bartoolina/Portable-Sig-Gen/schematics/dds_cahnnel_v1.pdf

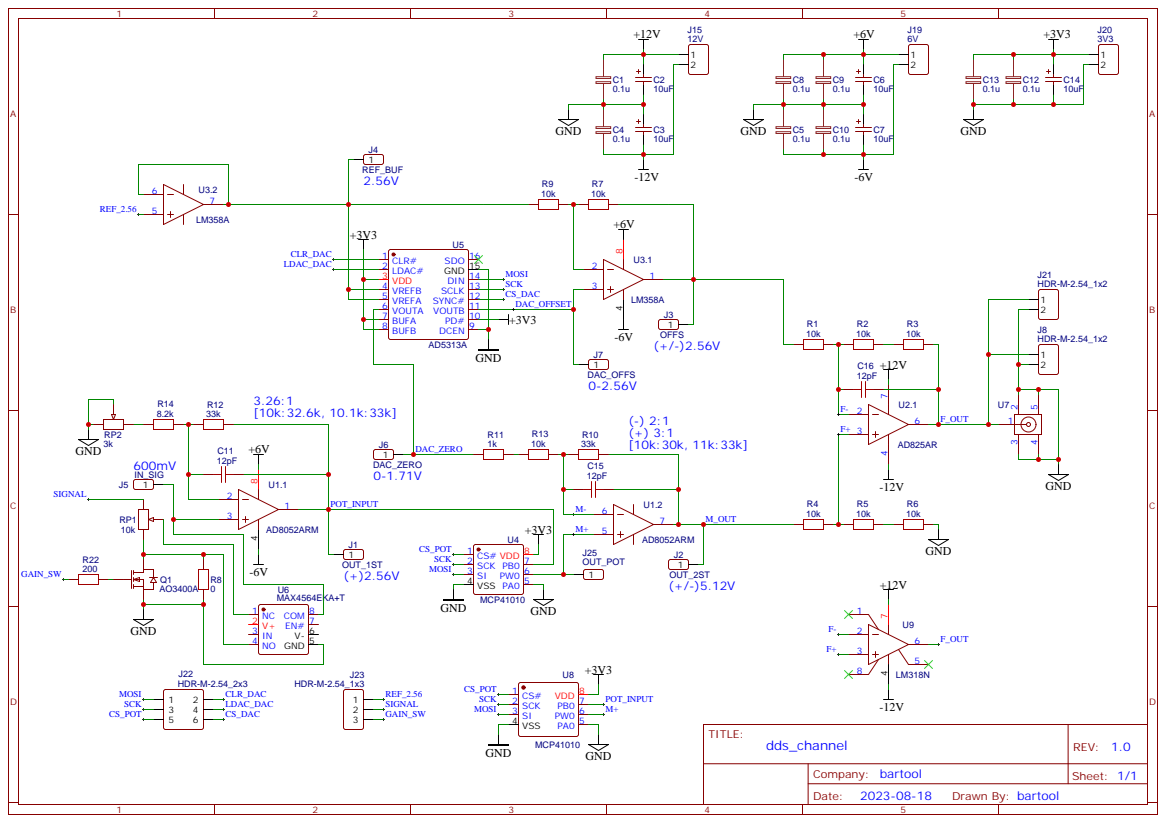
[picture p2: page 1]

PD# 10 VOUTB 11 SYNC# 12 SCLK 13 DIN 14 GND 15 SDO 16
