bartoolina/Portable-Sig-Gen/schematics/frontpanel_v1.pdf

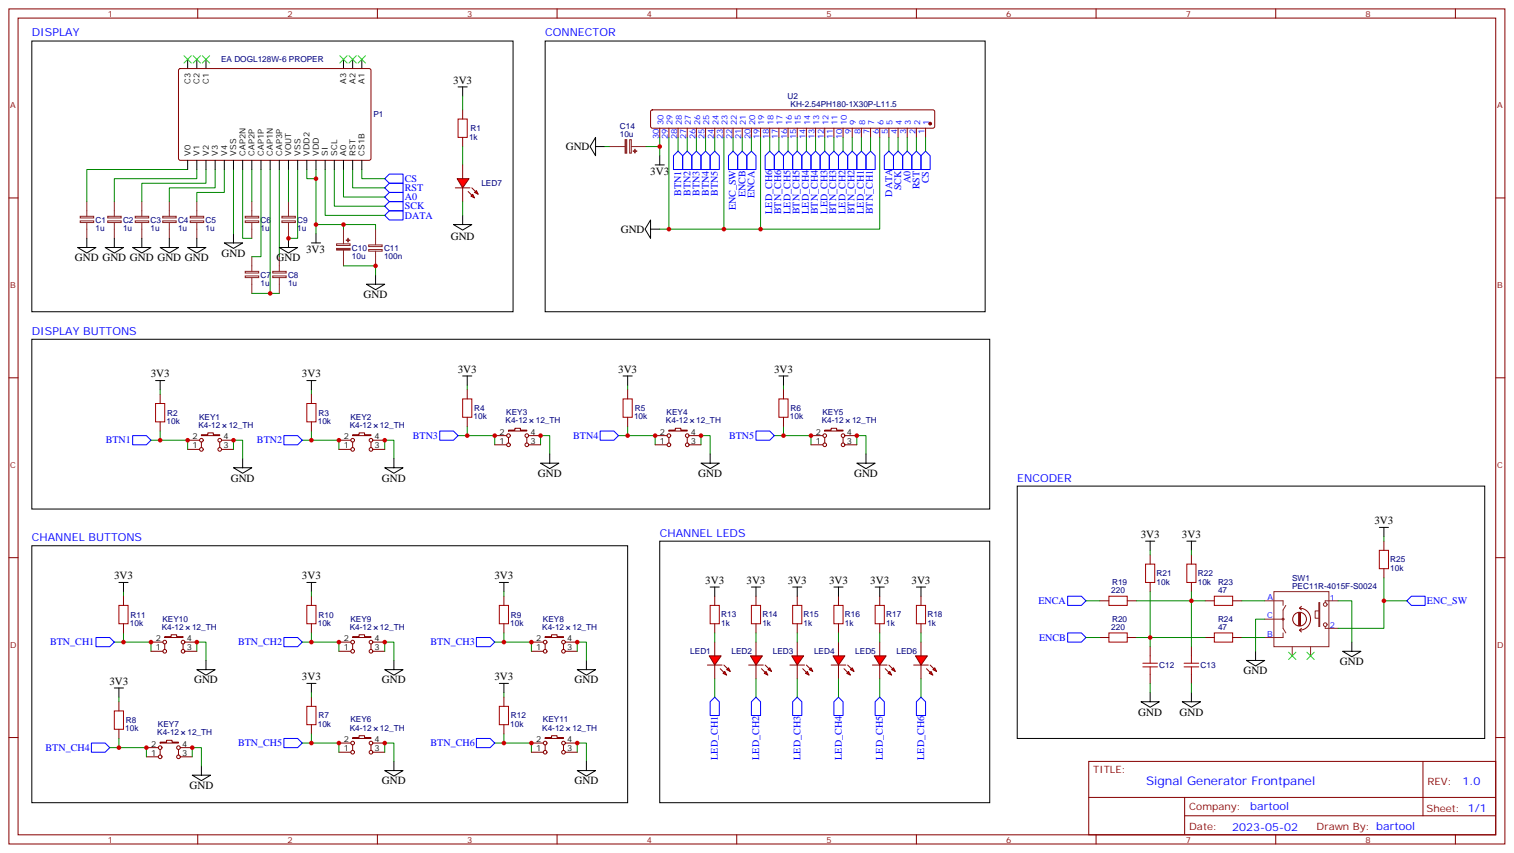
[picture p3: page 1]

GND GND GND
