bartoolina/Portable-Sig-Gen/schematics/dds_channel_v2.pdf

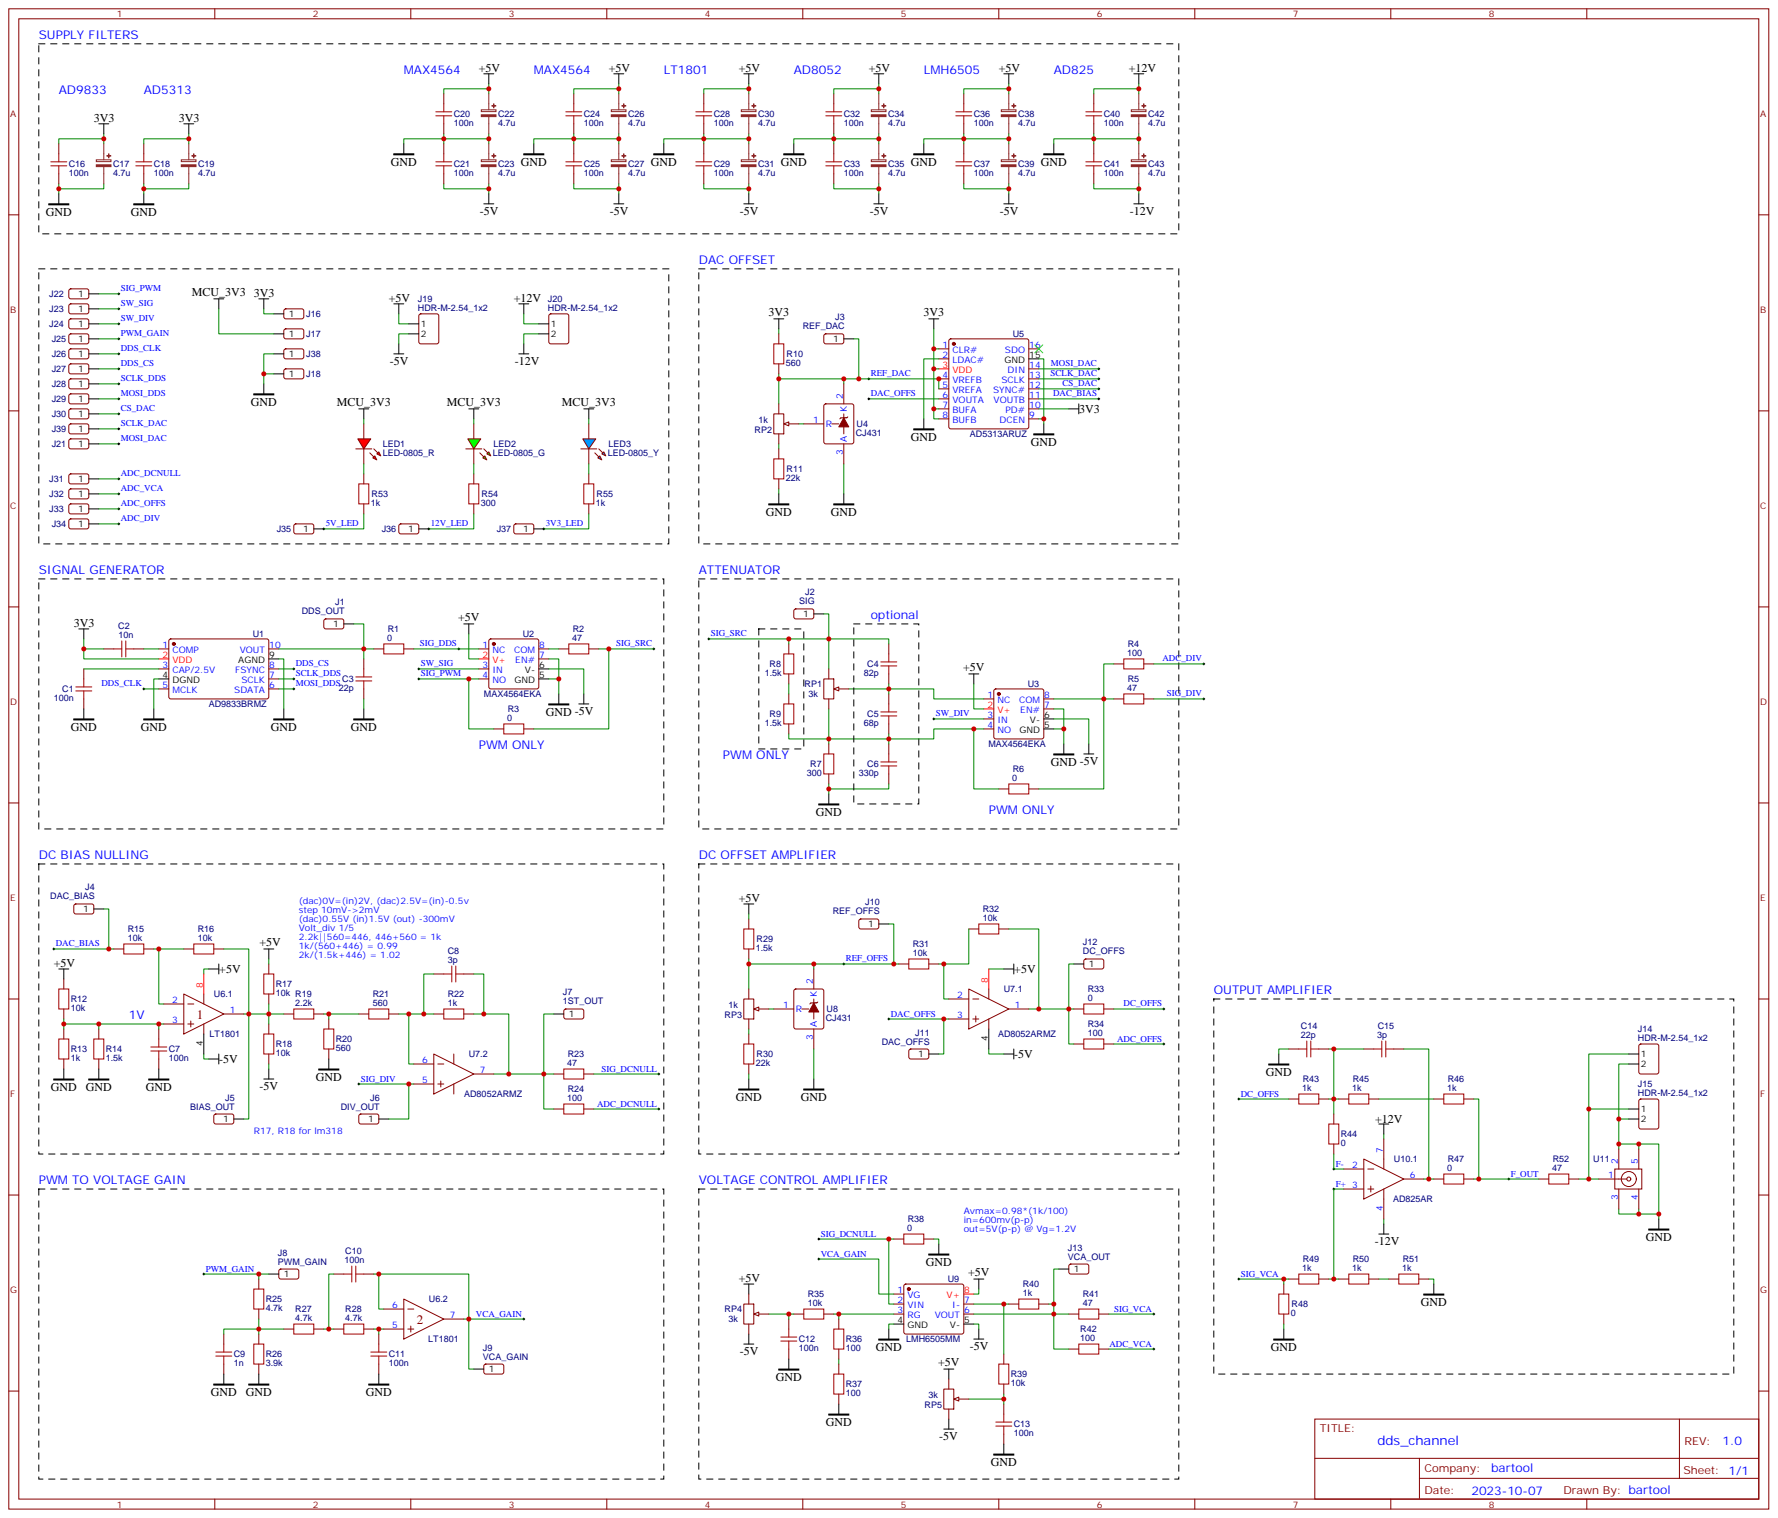
[picture p4: page 1]
