bartoolina/Portable-Sig-Gen/schematics/dds_test_board_v1.pdf

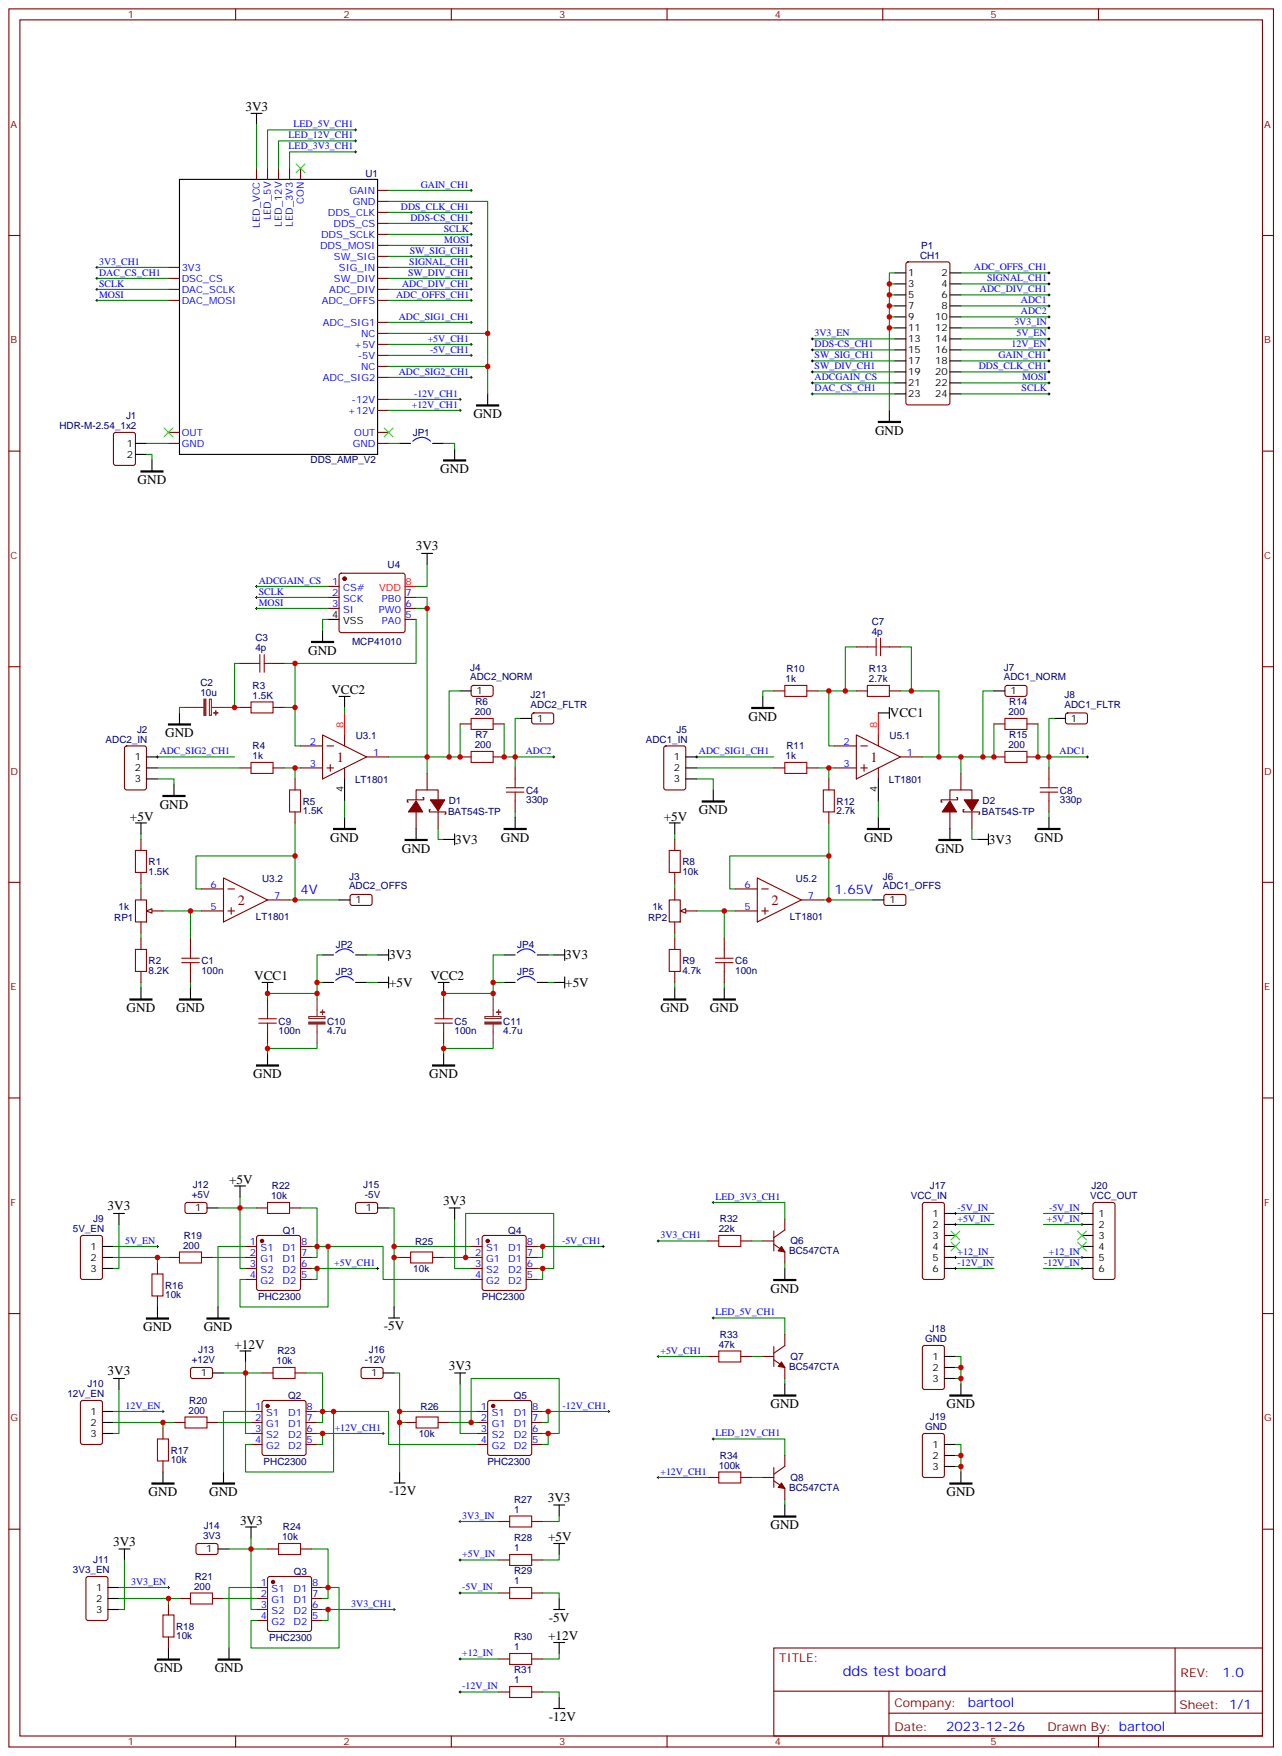
[picture p5: page 1]
