bartoolina/Portable-Sig-Gen/firmware/PortableSigGen_g474re_rtos/Core/Src/main.c

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
/* Includes ------------------------------------------------------------------*/
#include "main.h"
// #include "cmsis_os.h"
#include "usart.h"
#include "gpio.h"
#include "FreeRTOS.h"
#include "task.h"
/* USER CODE BEGIN Includes */
#include "SEGGER_SYSVIEW.h"
#include "SEGGER_RTT.h"
#include "printf.h"
/* USER CODE END Includes */


void SystemClock_Config(void);
void MX_FREERTOS_Init(void);
/* USER CODE BEGIN PFP */
void RTT_console_logger(ulog_level_t severity, char *msg);
void UART_console_logger(ulog_level_t severity, char *msg);
/* USER CODE END PFP */

/**
 * @brief  The application entry point.
 * @retval int
 */
int main(void)
{

	/* MCU Configuration--------------------------------------------------------*/

	/* Reset of all peripherals, Initializes the Flash interface and the Systick. */
	HAL_Init();

	/* Configure the system clock */
	SystemClock_Config();

	/* Initialize all configured peripherals */
	MX_GPIO_Init();
	MX_LPUART1_UART_Init();
	/* USER CODE BEGIN 2 */

	SEGGER_SYSVIEW_Conf();
	ulog_init();
	ulog_subscribe(RTT_console_logger, ULOG_DEBUG_LEVEL);
	ulog_subscribe(UART_console_logger, ULOG_WARNING_LEVEL);
	/* USER CODE END 2 */

	/* Init scheduler */
	// osKernelInitialize();

	/* Call init function for freertos objects (in cmsis_os2.c) */
	MX_FREERTOS_Init();

	/* Start scheduler */
	// osKernelStart();
	vTaskStartScheduler();
	/* We should never get here as control is now taken by the scheduler */

	/* Infinite loop */
	/* USER CODE BEGIN WHILE */
	while (1)
	{
		/* USER CODE END WHILE */

		/* USER CODE BEGIN 3 */
	}
	/* USER CODE END 3 */
}

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
/* USER CODE BEGIN 4 */
void RTT_console_logger(ulog_level_t severity, char *msg)
{
	SEGGER_RTT_printf(0, "[%s]: %s\n", ulog_level_name(severity), msg);
	// SEGGER_SYSVIEW_PrintfTarget("[%s]: %s\n", ulog_level_name(severity), msg);
}
void UART_console_logger(ulog_level_t severity, char *msg)
{
	uint8_t _msg[32] = {0};
	uint8_t _msg_lenght = snprintf((char *)_msg, 32, "[%s]: %s\n", ulog_level_name(severity), msg);
	HAL_UART_Transmit(&hlpuart1, _msg, _msg_lenght, 1000);
}
/* USER CODE END 4 */

/**
 * @brief  Period elapsed callback in non blocking mode
 * @note   This function is called  when TIM17 interrupt took place, inside
 * HAL_TIM_IRQHandler(). It makes a direct call to HAL_IncTick() to increment
 * a global variable "uwTick" used as application time base.
 * @param  htim : TIM handle
 * @retval None
 */
void HAL_TIM_PeriodElapsedCallback(TIM_HandleTypeDef *htim)
{
	if (htim->Instance == TIM17)
	{
		HAL_IncTick();
	}
}

/**
 * @brief  This function is executed in case of error occurrence.
 * @retval None
 */
void Error_Handler(void)
{
	/* USER CODE BEGIN Error_Handler_Debug */
	/* User can add his own implementation to report the HAL error return state */
	__disable_irq();
	while (1)
	{
	}
	/* USER CODE END Error_Handler_Debug */
}

#ifdef USE_FULL_ASSERT
/**
 * @brief  Reports the name of the source file and the source line number
 *         where the assert_param error has occurred.
 * @param  file: pointer to the source file name
 * @param  line: assert_param error line source number
 * @retval None
 */
void assert_failed(uint8_t *file, uint32_t line)
{
	/* USER CODE BEGIN 6 */
	/* User can add his own implementation to report the file name and line number,
	   ex: printf("Wrong parameters value: file %s on line %d\r\n", file, line) */
	/* USER CODE END 6 */
}
#endif /* USE_FULL_ASSERT */
