bartoolina/Portable-Sig-Gen/(commit log)

2024-09-28 add schematics
2024-10-05 add hw_button driver
2024-10-05 add printf
