bartoolina/Portable-Sig-Gen/(notices)

Notices in the files:
firmware/PortableSigGen_g474re_rtos/Core/Src/main.c:
Copyright (c) 2024 STMicroelectronics.
All rights reserved.
This software is licensed under terms that can be found in the LICENSE file
